nchudson/ENGE420-Project/Planning/GetupPoster/Slide1.png

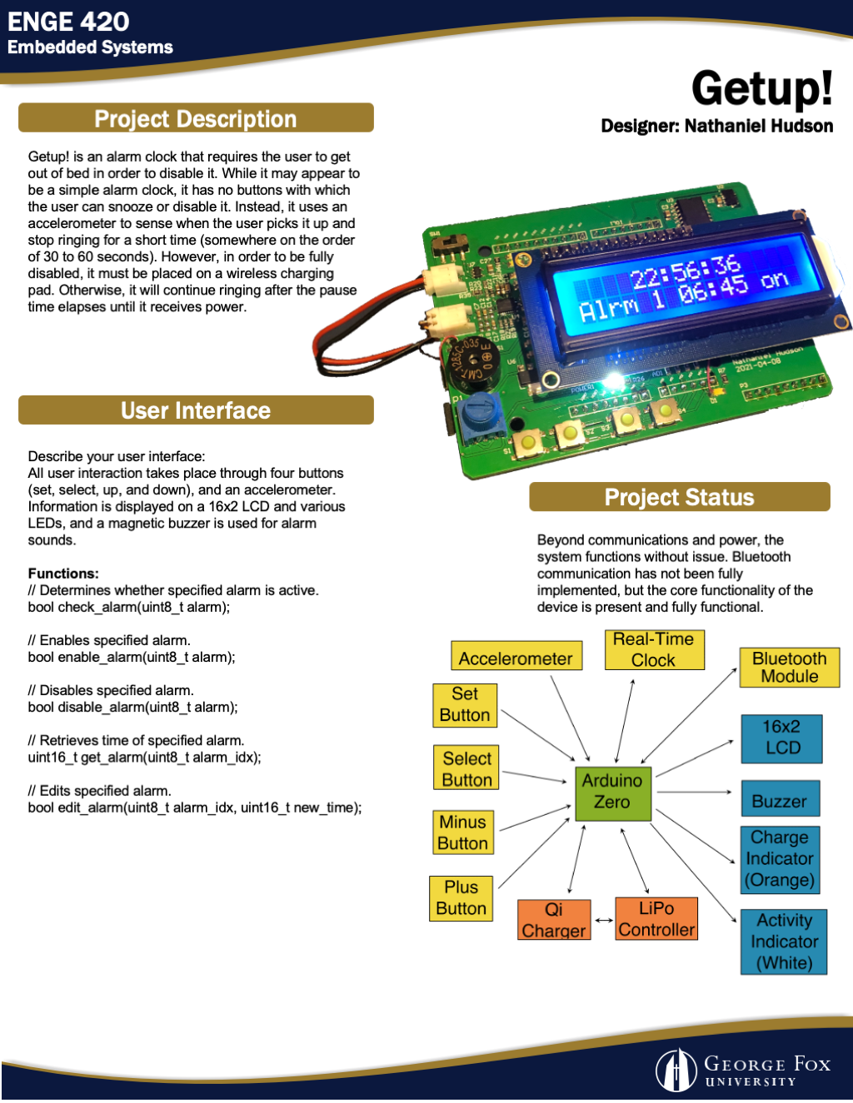
Planning/GetupPoster/Slide1.png
