nchudson/ENGE420-Project/Datasheets/ADXLBoard.png

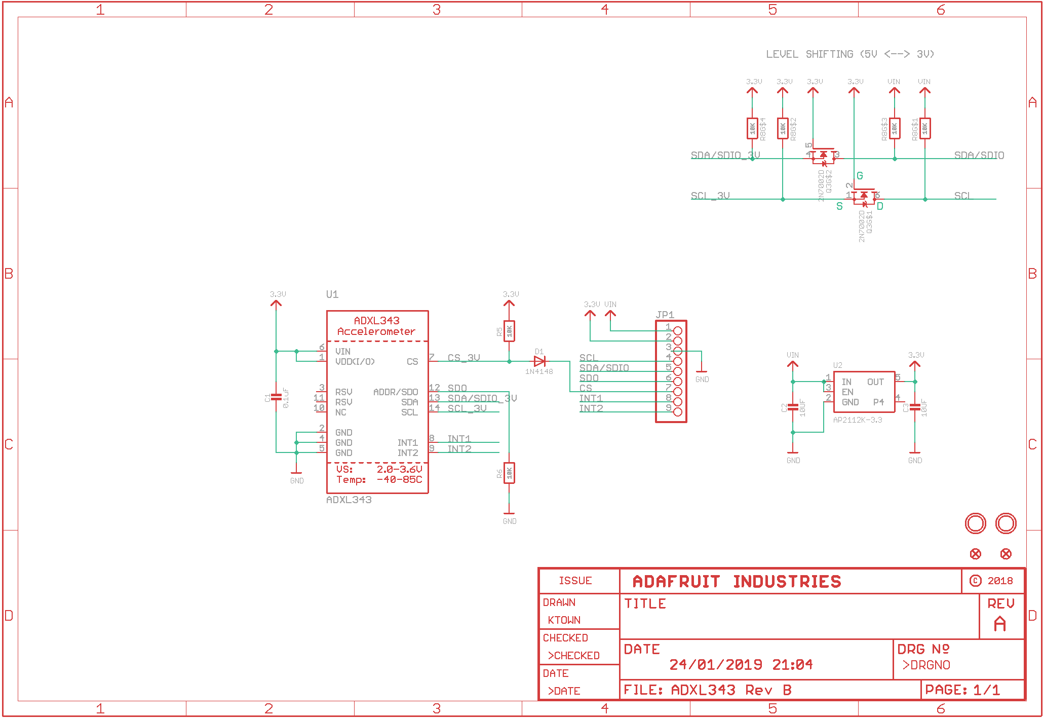
Datasheets/ADXLBoard.png
