nchudson/ENGE420-Project/Datasheets/lcds___displays_schem.png

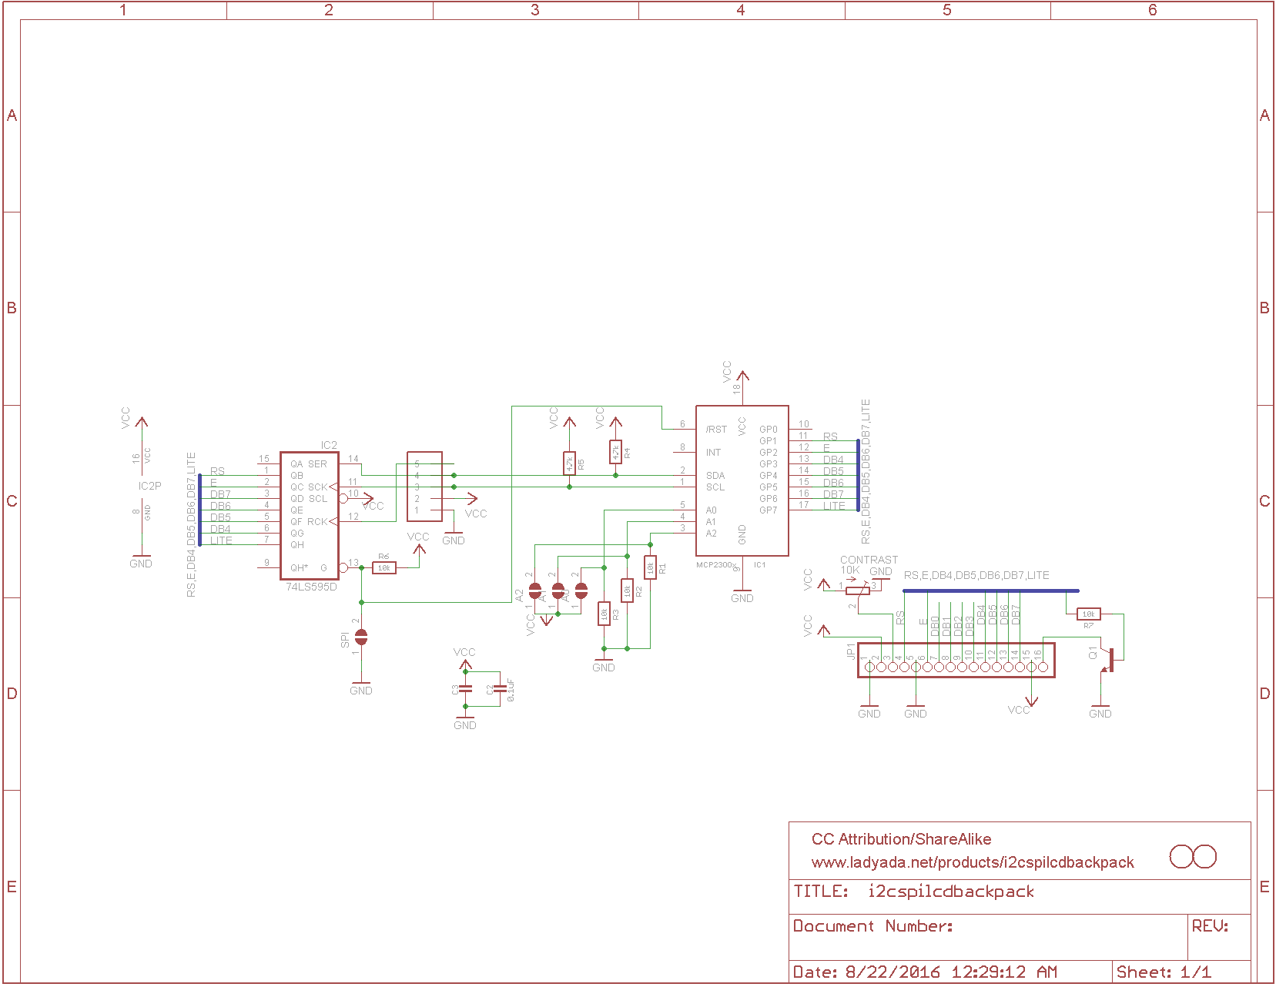
Datasheets/lcds___displays_schem.png
