nchudson/ENGE420-Project/Planning/Block Diagram.png

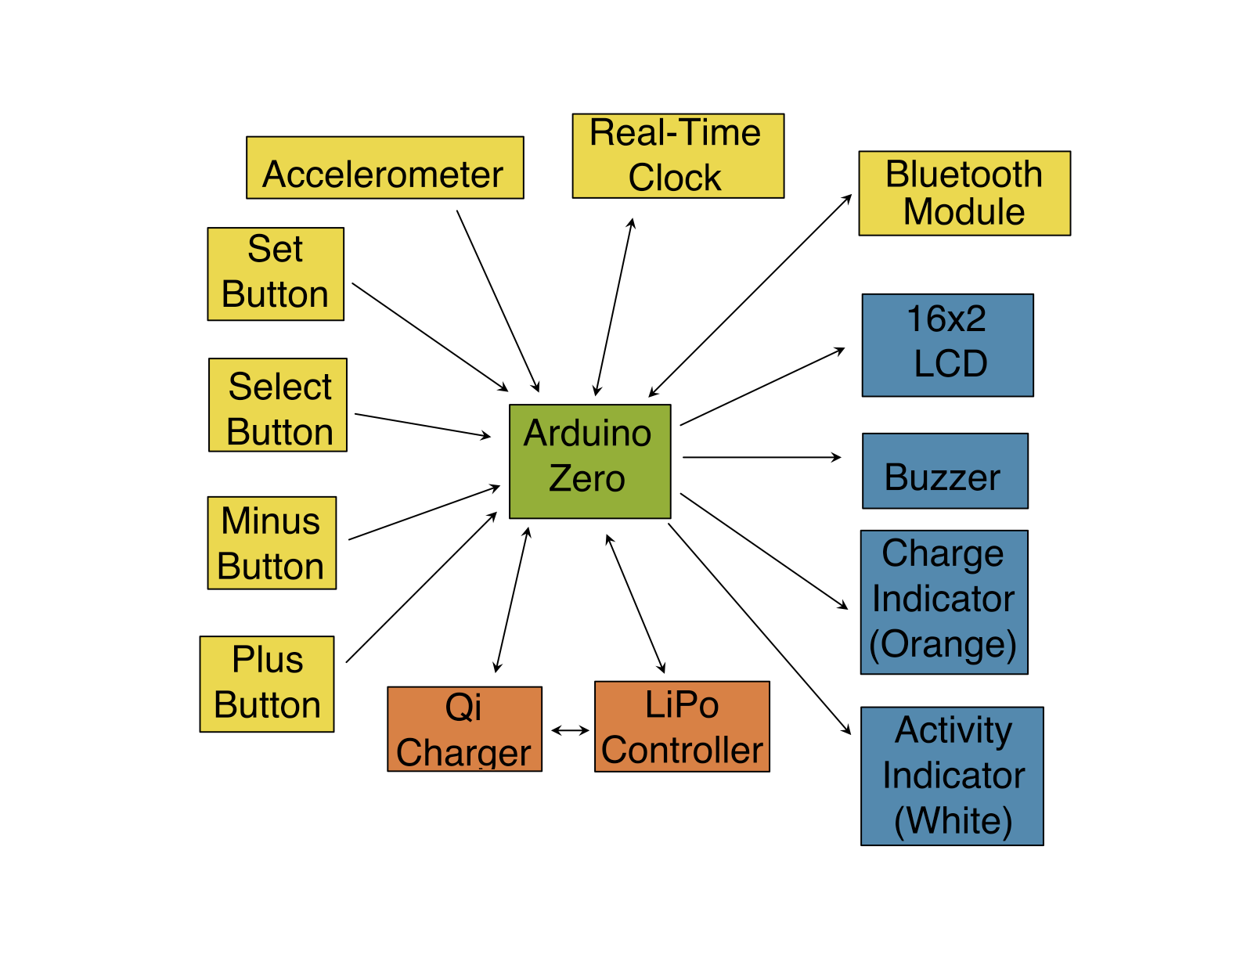
Planning/Block Diagram.png
