nchudson/ENGE420-Project/Planning/RoughHousing.png

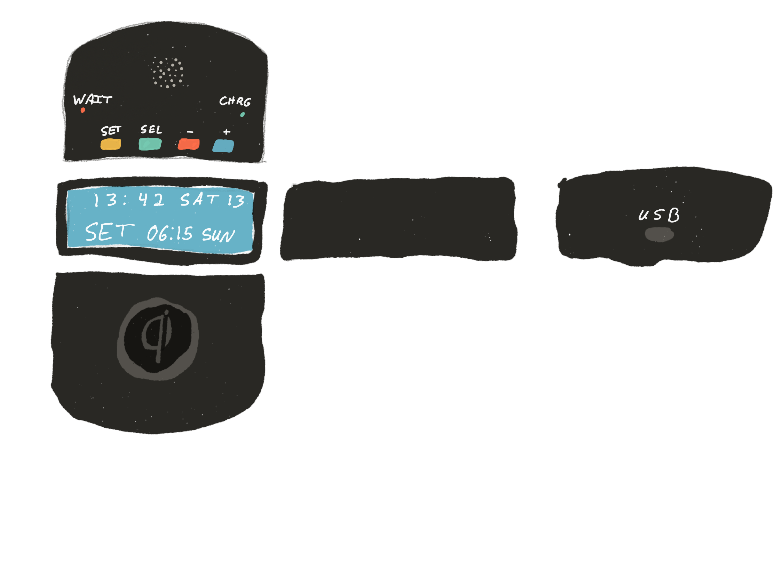
Planning/RoughHousing.png
