nchudson/ENGE420-Project/Planning/GetupSchematic.pdf

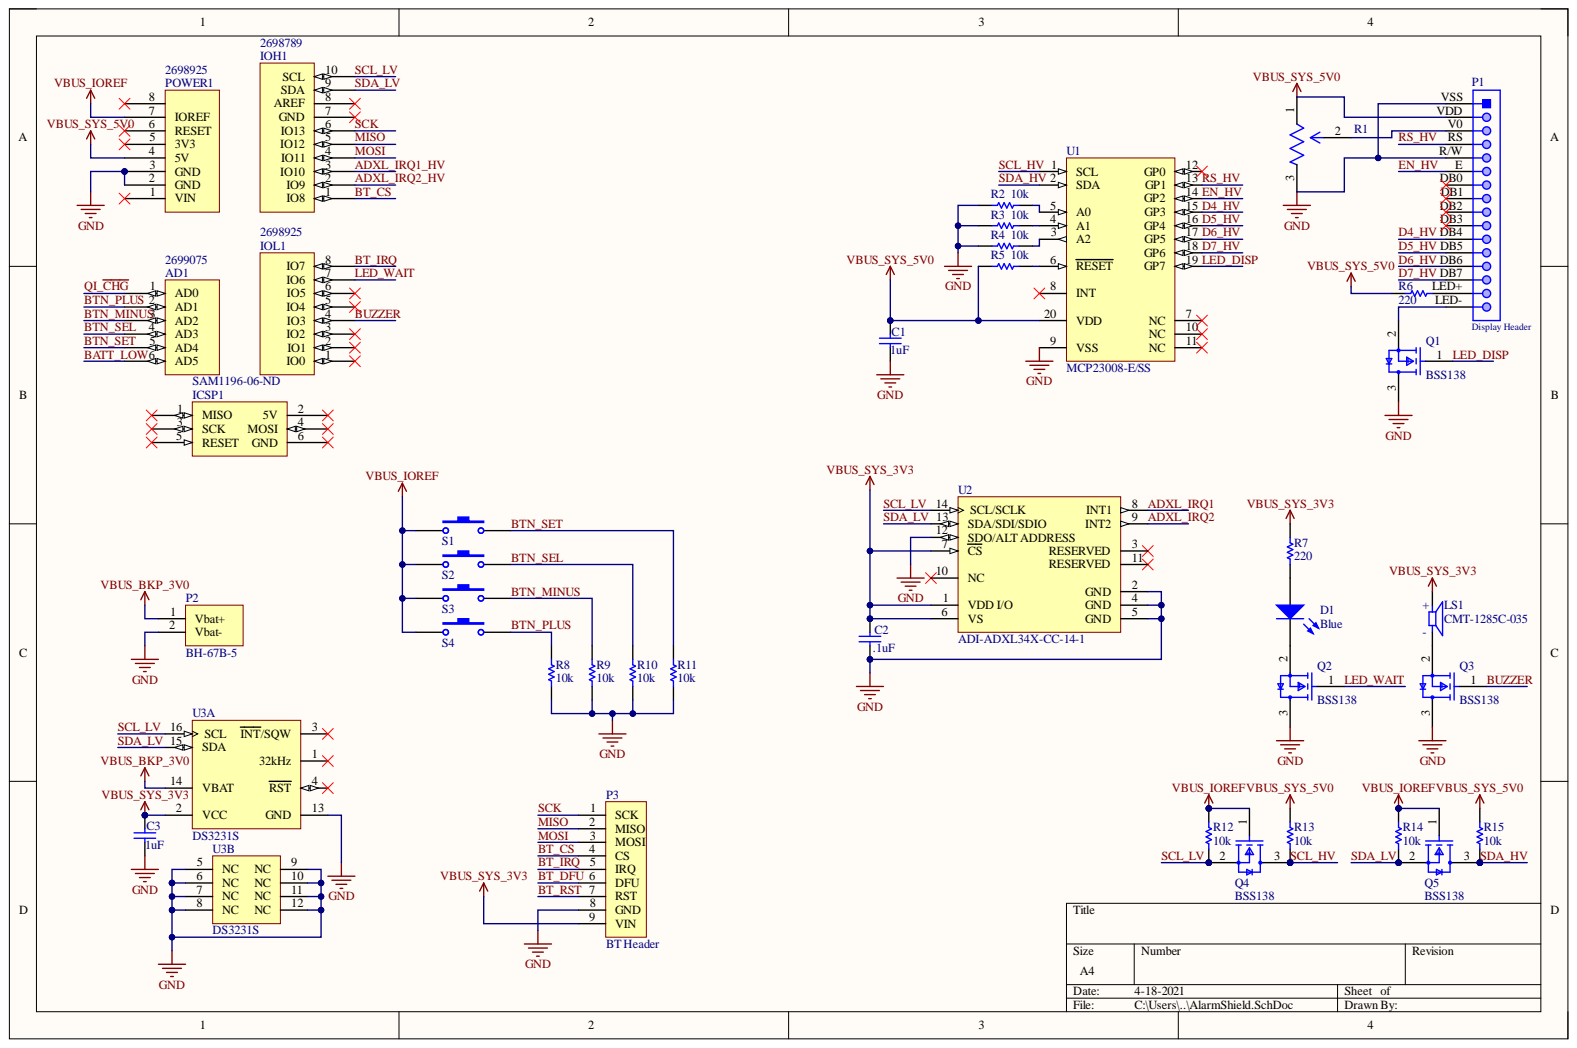
[picture p6: page 1]

S i z e A4 | Numb e r | R e vision

Date : 4-18-2 0 2 1 | She et of
F ile : C :\Use rs\. .\A l a rmShi e ld. S chDo c | Dr awn By:

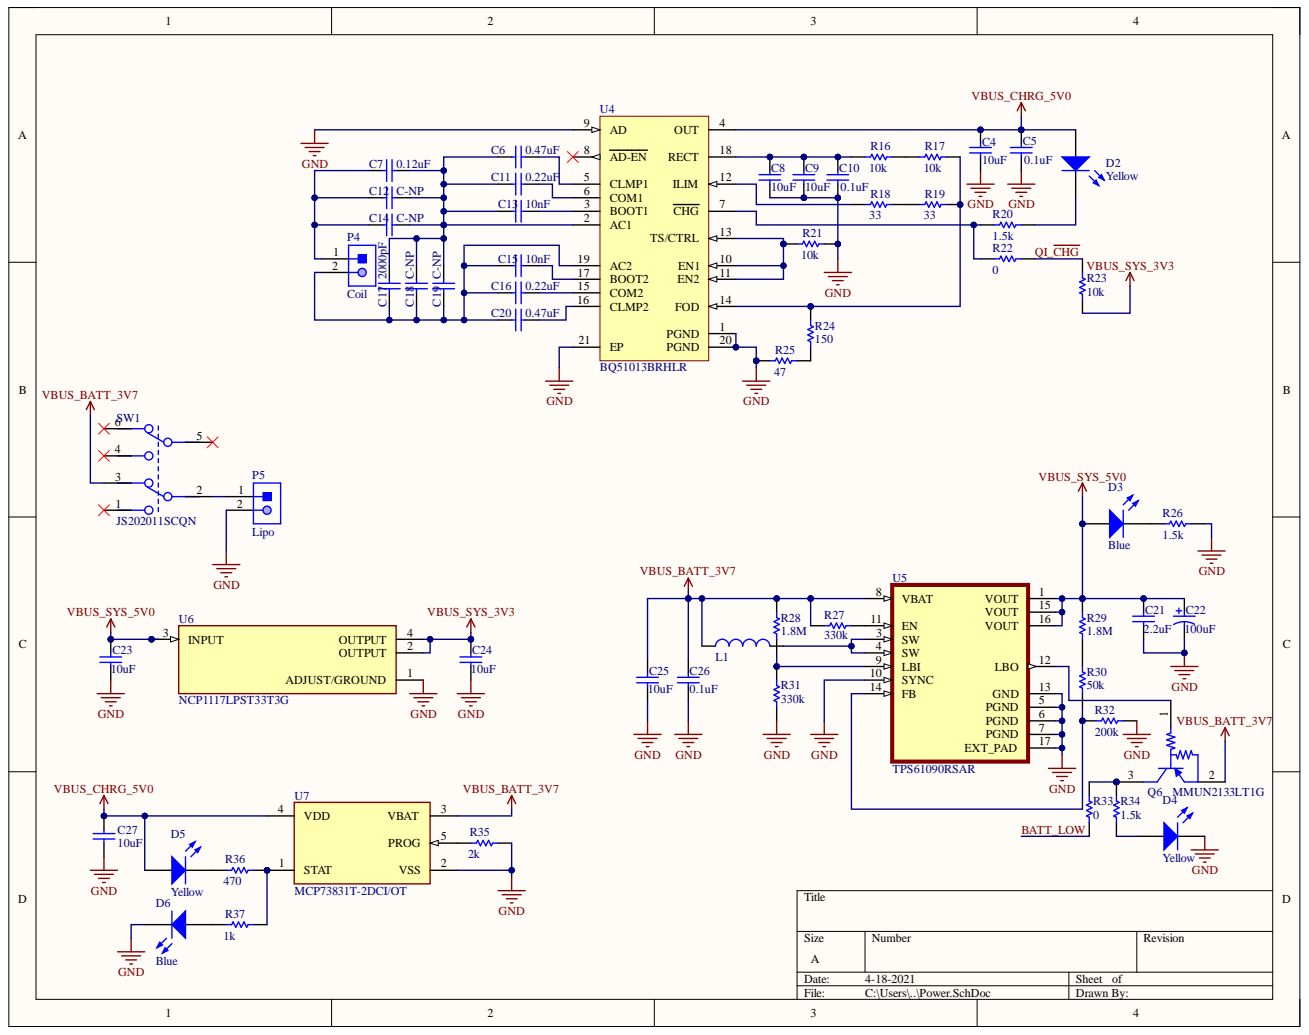
[picture p7: page 2]

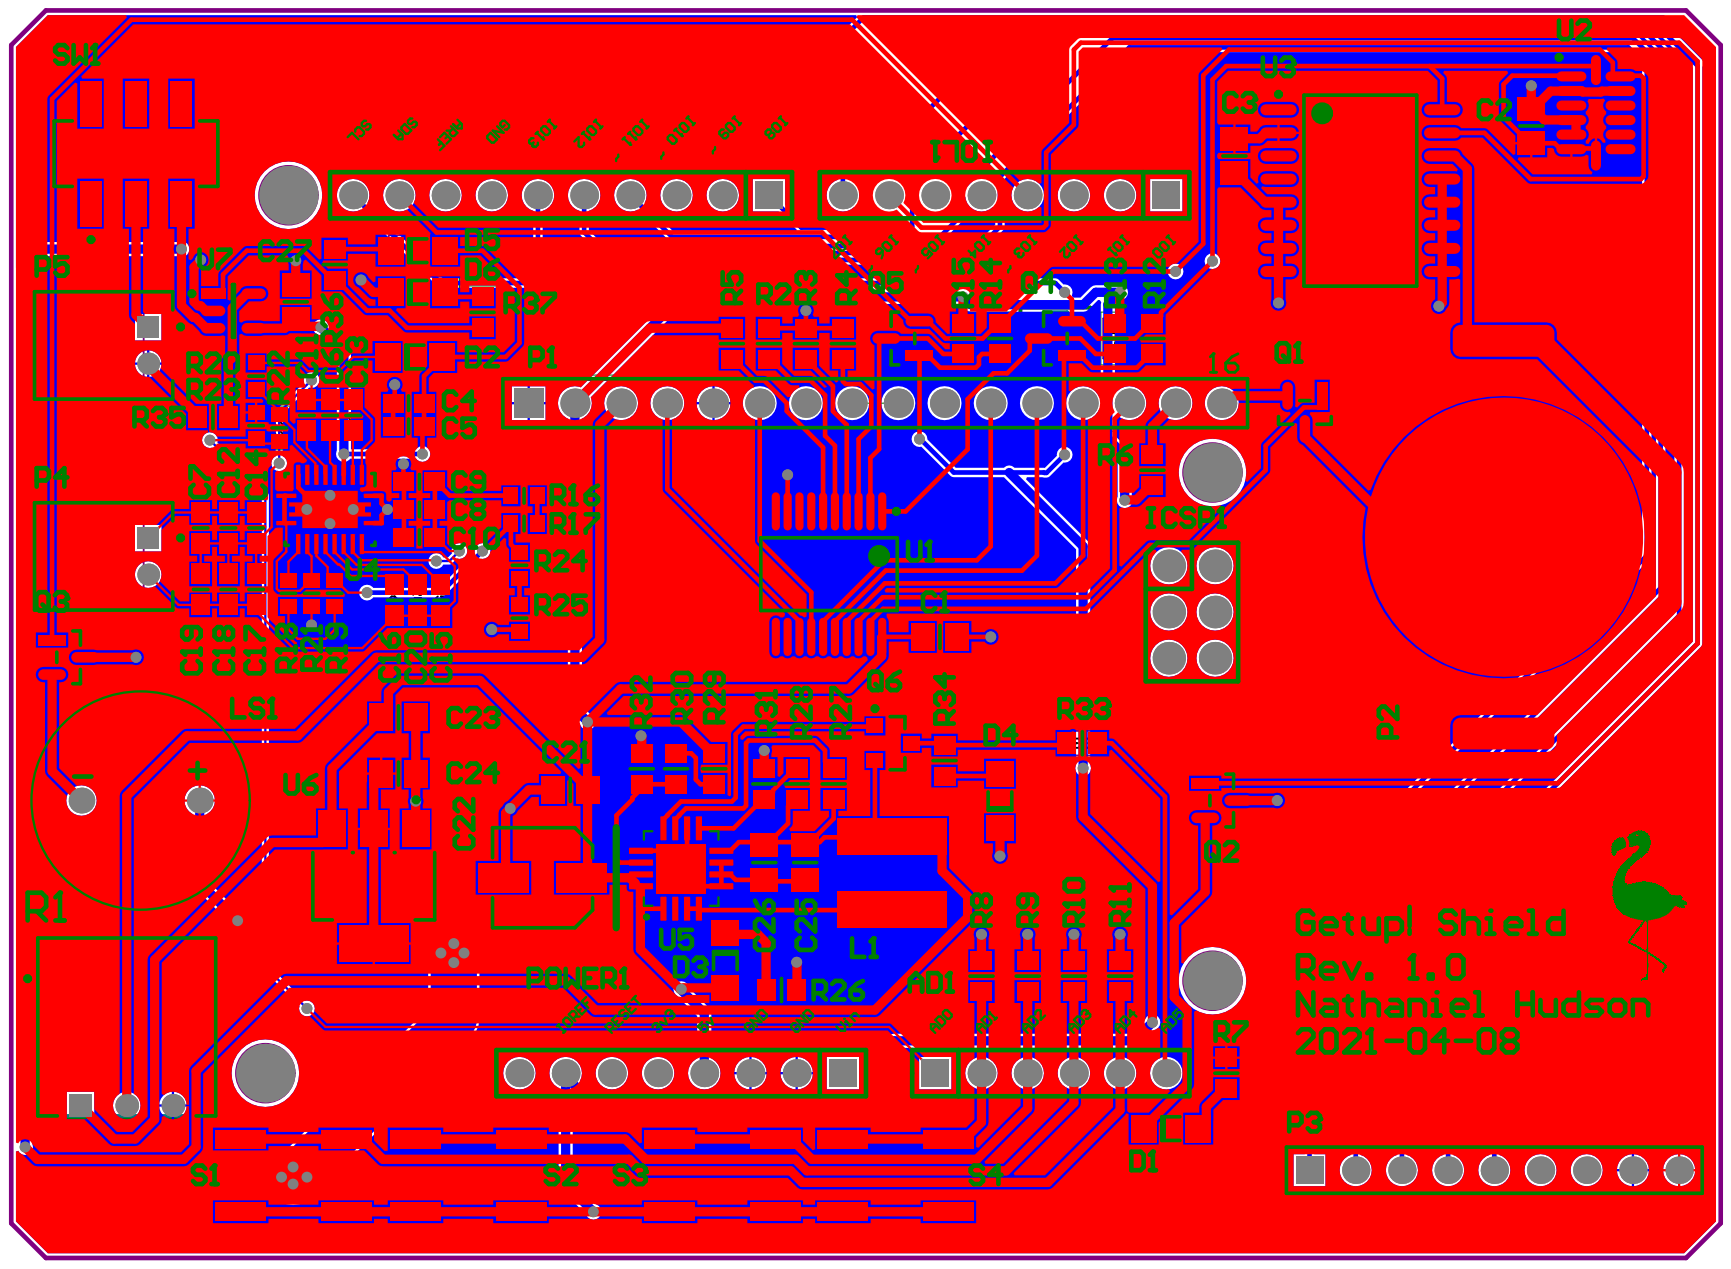
[picture p8: page 3]

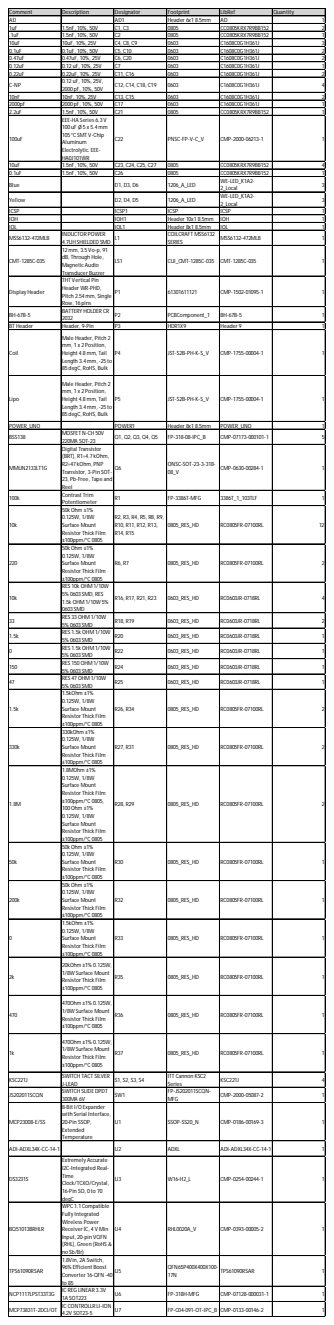
[picture p9: page 4]

1uF | 1.5nF, 10%, 50V | C1, C3 | 0805 | CC0805KRX7R9BB152 | | 2
.1uF | 1.5nF, 10%, 50V | C2 | 0805 | CC0805KRX7R9BB152 | | 1
10uF | 10uF, 10%, 25V | C4, C8, C9 | 0603 | C1608C0G1H361J | | 3
0.1uF | 0.1uF, 10%, 50V | C5, C10 | 0603 | C1608C0G1H361J | | 2
0.47uF | 0.47uF, 10%, 25V | C6, C20 | 0603 | C1608C0G1H361J | | 2
0.12uF | 0.12 uF, 10%, 25V | C7 | 0603 | C1608C0G1H361J | | 1
0.22uF | 0.22uF, 10%, 25V | C11, C16 | 0603 | C1608C0G1H361J | | 2
C-NP | 0.12 uF, 10%, 25V, 2000 pF, 10%, 50V | C12, C14, C18, C19 | 0603 | C1608C0G1H361J | | 4

10nF | 10nF, 10%, 25V | C13, C15 | 0603 | C1608C0G1H361J | | 2
2000pF | 2000 pF, 10%, 50V | C17 | 0603 | C1608C0G1H361J | | 1
2.2uF | 1.5nF, 10%, 50V | C21 | 0805 | CC0805KRX7R9BB152 | | 1
100uF | EEE-HA Series 6.3 V 100 uF Ø 5 x 5.4mm 105 °C SMT V-Chip Aluminum Electrolytic. EEE-HA0J101WR | C22 | PNSC-FP-V-C_V | CMP-2000-06213-1 | | 1

10uF | 1.5nF, 10%, 50V | C23, C24, C25, C27 | 0805 | CC0805KRX7R9BB152 | | 4
0.1uF | 1.5nF, 10%, 50V | C26 | 0805 | CC0805KRX7R9BB152 | | 1
Blue | | D1, D3, D6 | 1206_A_LED | WE-LED_K1A2-2_Local | | 3

Yellow | | D2, D4, D5 | 1206_A_LED | WE-LED_K1A2-2_Local | | 3

ICSP | | ICSP1 | ICSP | ICSP | | 1
IOH | | IOH1 | Header 10x1 8.5mm | IOH | | 1
IOL | | IOL1 | Header 8x1 8.5mm | IOL | | 1
MSS6132-472MLB | INDUCTOR POWER 4.7UH SHIELDED SMD | L1 | COILCRAFT MSS6132 SERIES | MSS6132-472MLB | | 1

CMT-1285C-035 | 12mm, 3.5 Vo-p, 91 dB, Through Hole, Magnetic Audio Transducer Buzzer | LS1 | CUI_CMT-1285C-035 | CMT-1285C-035 | | 1

Display Header | THT Vertical Pin Header WR-PHD, Pitch 2.54mm, Single Row, 16 pins | P1 | 61301611121 | CMP-1502-01095-1 | | 1

BH-67B-5 | BATTERY HOLDER CR 2032 | P2 | PCBComponent_1 | BH-67B-5 | | 1

BT Header | Header, 9-Pin | P3 | HDR1X9 | Header 9 | | 1

Coil | Male Header, Pitch 2 mm, 1 x 2 Position, Height 4.8mm, Tail Length 3.4mm, -25 to 85 degC, RoHS, Bulk | P4 | JST-S2B-PH-K-S_V | CMP-1755-00004-1 | | 1

Lipo | Male Header, Pitch 2 mm, 1 x 2 Position, Height 4.8mm, Tail Length 3.4mm, -25 to 85 degC, RoHS, Bulk | P5 | JST-S2B-PH-K-S_V | CMP-1755-00004-1 | | 1

POWER_UNO | | POWER1 | Header 8x1 8.5mm | POWER_UNO | | 1
BSS138 | MOSFET N-CH 50V 220MA SOT-23 | Q1, Q2, Q3, Q4, Q5 | FP-318-08-IPC_B | CMP-07173-000101-1 | | 5

MMUN2133LT1G | Digital Transistor (BRT), R1=4.7 kOhm, R2=47 kOhm, PNP Transistor, 3-Pin SOT-23, Pb-Free, Tape and Reel | Q6 | ONSC-SOT-23-3-318-08_V | CMP-0630-00284-1 | | 1

100k | Contrast Trim Potentiometer | R1 | FP-3386T-MFG | 3386T_1_103TLF | | 1

10k | 50k Ohm ±1% 0.125W, 1/8W Surface Mount Resistor Thick Film ±100ppm/°C 0805 | R2, R3, R4, R5, R8, R9, R10, R11, R12, R13, R14, R15 | 0805_RES_HD | RC0805FR-07100RL | 12

220 | 50k Ohm ±1% 0.125W, 1/8W Surface Mount Resistor Thick Film ±100ppm/°C 0805 | R6, R7 | 0805_RES_HD | RC0805FR-07100RL | | 2

10k | RES 10k OHM 1/10W 5% 0603 SMD, RES 1.5k OHM 1/10W 5% 0603 SMD | R16, R17, R21, R23 | 0603_RES_HD | RC0603JR-0718RL | | 4

33 | RES 33OHM 1/10W 5% 0603 SMD | R18, R19 | 0603_RES_HD | RC0603JR-0718RL | | 2

1.5k | RES 1.5k OHM 1/10W 5% 0603 SMD | R20 | 0603_RES_HD | RC0603JR-0718RL | | 1

0 | RES 1.5k OHM 1/10W 5% 0603 SMD | R22 | 0603_RES_HD | RC0603JR-0718RL | | 1

150 | RES 150OHM 1/10W 5% 0603 SMD | R24 | 0603_RES_HD | RC0603JR-0718RL | | 1

47 | RES 47OHM 1/10W 5% 0603 SMD | R25 | 0603_RES_HD | RC0603JR-0718RL | | 1

1.5k | 1.5kOhm ±1% 0.125W, 1/8W Surface Mount Resistor Thick Film ±100ppm/°C 0805 | R26, R34 | 0805_RES_HD | RC0805FR-07100RL | | 2

330k | 330kOhm ±1% 0.125W, 1/8W Surface Mount Resistor Thick Film ±100ppm/°C 0805 | R27, R31 | 0805_RES_HD | RC0805FR-07100RL | | 2

1.8M | 1.8MOhm ±1% 0.125W, 1/8W Surface Mount Resistor Thick Film ±100ppm/°C 0805, 100Ohm ±1% 0.125W, 1/8W Surface Mount Resistor Thick Film ±100ppm/°C 0805 | R28, R29 | 0805_RES_HD | RC0805FR-07100RL | | 2

50k | 50k Ohm ±1% 0.125W, 1/8W Surface Mount Resistor Thick Film ±100ppm/°C 0805 | R30 | 0805_RES_HD | RC0805FR-07100RL | | 1

200k | 50k Ohm ±1% 0.125W, 1/8W Surface Mount Resistor Thick Film ±100ppm/°C 0805 | R32 | 0805_RES_HD | RC0805FR-07100RL | | 1

0 | 1.5kOhm ±1% 0.125W, 1/8W Surface Mount Resistor Thick Film ±100ppm/°C 0805 | R33 | 0805_RES_HD | RC0805FR-07100RL | | 1

2k | 20kOhm ±1% 0.125W, 1/8W Surface Mount Resistor Thick Film ±100ppm/°C 0805 | R35 | 0805_RES_HD | RC0805FR-07100RL | | 1

470 | 470Ohm ±1% 0.125W, 1/8W Surface Mount Resistor Thick Film ±100ppm/°C 0805 | R36 | 0805_RES_HD | RC0805FR-07100RL | | 1

1k | 470Ohm ±1% 0.125W, 1/8W Surface Mount Resistor Thick Film ±100ppm/°C 0805 | R37 | 0805_RES_HD | RC0805FR-07100RL | | 1

KSC221J | J-LEAD SWITCH TACT SILVER | S1, S2, S3, S4 | ITT Cannon KSC2 Series | KSC221J | | 4

JS202011SCQN | SWITCH SLIDE DPDT 300MA 6V | SW1 | FP-JS202011SCQN-MFG | CMP-2000-05087-2 | | 1

MCP23008-E/SS | 8-Bit I/O Expander with Serial Interface, 20-Pin SSOP, Extended Temperature | U1 | SSOP-SS20_N | CMP-0186-00169-3 | | 1

ADI-ADXL34X-CC-14-1 | | U2 | ADXL | ADI-ADXL34X-CC-14-1 | | 1

DS3231S | Extremely Accurate I2C-Integrated Real-Time Clock/TCXO/Crystal, 16-Pin SO, 0 to 70 degC | U3 | W16-H2_L | CMP-0254-00244-1 | | 1

BQ51013BRHLR | WPC 1.1 Compatible Fully Integrated Wireless Power Receiver IC, 4 V Min Input, 20-pin VQFN (RHL), Green (RoHS & no Sb/Br) | U4 | RHL0020A_V | CMP-0393-00005-2 | | 1

TPS61090RSAR | 1.8Vin, 2A Switch, 96% Efficient Boost Converter 16-QFN -40 to 85 | U5 | QFN65P400X400X100-17N | TPS61090RSAR | | 1

NCP1117LPST33T3G | IC REG LINEAR 3.3V 1A SOT223 | U6 | FP-318H-MFG | CMP-07128-000031-1 | | 1

MCP73831T-2DCI/OT | IC CONTROLLR LI-ION 4.2V SOT23-5 | U7 | FP-C04-091-OT-IPC_B | CMP-0133-00146-2 | | 1
