nchudson/ENGE420-Project/Planning/Block Diagram.pdf

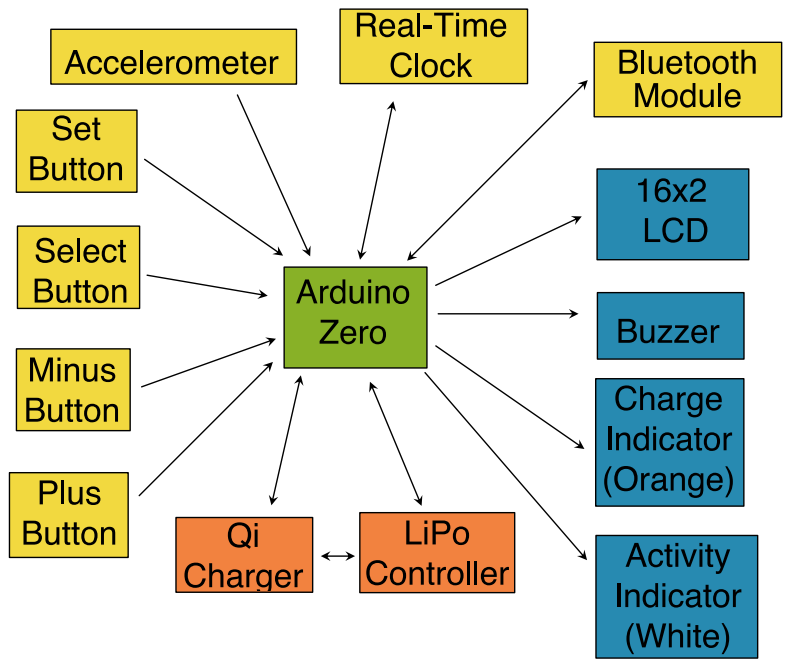
[picture p10: page 1]
Arduino Zero; 16x2 LCD; Buzzer; Charge Indicator (Orange); Activity Indicator (White); Accelerometer; Set Button; Select Button; Minus Button; Plus; Button; Charger; LiPo Controller; Real-Time; Clock; Bluetooth; Module
