nchudson/ENGE420-Project/(list of files, drawings)

Other design files:
Altium/8-TSSOP.PcbLib
Altium/1206_A.PcbLib
Altium/ADI-ADXL34X-CC-14-1.SchLib
Altium/ADI-CC-14-1_V.PcbLib
Altium/ADXL.PcbLib
Altium/ADXL.SchLib
Altium/AlarmShield.PcbDoc
Altium/AlarmShield.PrjPcb
Altium/AlarmShield.SchDoc
Altium/BatteryHolder.PcbLib
Altium/BatteryHolder.SchLib
Altium/CFS20632768EZBB.PcbLib
Altium/CFS-20632768EZBB.SchLib
Altium/CMT-1285C-035.SchLib
Altium/ContrastPot.PcbLib
Altium/ContrastPot.SchLib
Altium/CUI_CMT-1285C-035.PcbLib
Altium/Header.PcbLib
Altium/Header.SchLib
Altium/Power.SchDoc
Altium/QFN65P400X400X100-17N.PcbLib
Altium/RTC.SchLib
Altium/TPS61090RSAR.SchLib
Altium/WE-LED_K1A2-2.SchLib
