nchudson/ENGE420-Project/(commit log)

2021-03-23 Worked on schematic
    [8-TSSOP.PcbLib, AlarmShield.PcbDoc, AlarmShield.PrjPcb, AlarmShield.SchDoc, BatteryHolder.PcbLib, BatteryHolder.SchLib, CFS-20632768EZBB.SchLib, CFS20632768EZBB.PcbLib]
2021-03-25 Some more work
    [AlarmShield.PrjPcb, AlarmShield.SchDoc]
2021-03-27 More schematic work.
    [AlarmShield.PrjPcb, AlarmShield.SchDoc, QFN65P400X400X100-17N.PcbLib, TPS61090RSAR.SchLib]
2021-03-27 Yet more schematic work.
    [AlarmShield.SchDoc]
2021-03-29 More schematic work. Shoot me now.
    [AlarmShield.PrjPcb, AlarmShield.SchDoc, LevelShifters.SchDoc, Power.SchDoc]
2021-03-30 Schematic and layout work.
    [AlarmShield.PcbDoc, AlarmShield.PrjPcb, AlarmShield.SchDoc, LevelShifters.SchDoc, Power.SchDoc, QFN65P400X400X100-17N.PcbLib]
2021-04-06 Work on layout
    [AlarmShield.PcbDoc, AlarmShield.SchDoc, Power.SchDoc]
2021-04-07 Layout work
    [AlarmShield.PcbDoc, AlarmShield.SchDoc, QFN65P400X400X100-17N.PcbLib]
2021-04-08 Almost done
    [1206_A.PcbLib, AlarmShield.PcbDoc, AlarmShield.PrjPcb, AlarmShield.SchDoc, Power.SchDoc, WE-LED_K1A2-2.SchLib]
2021-04-08 More layout changes
    [ADI-ADXL34X-CC-14-1.SchLib, ADI-CC-14-1_V.PcbLib, ADXL.PcbLib, ADXL.SchLib, AlarmShield.PcbDoc, AlarmShield.PrjPcb, AlarmShield.SchDoc, ContrastPot.PcbLib]
2021-04-09 Board should be complete
    [1206_A.PcbLib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]
2021-04-15 Altium saves oddly
    [AlarmShield.PrjPcb]
2021-04-15 Add solder paste file
    [AlarmShield.PrjPcb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]
2021-04-18 Altium changes things far too often
    [AlarmShield.PrjPcb]
2021-04-19 Add buzzer test code
    [main.cpp]
2021-04-22 Altium changes
    [AlarmShield.PrjPcb]
2021-04-24 Sensor testing and internal RTC implementation
